CoreElectronics/CE-PiicoDev-Button/Documents/CE-PiicoDev-Button.pdf

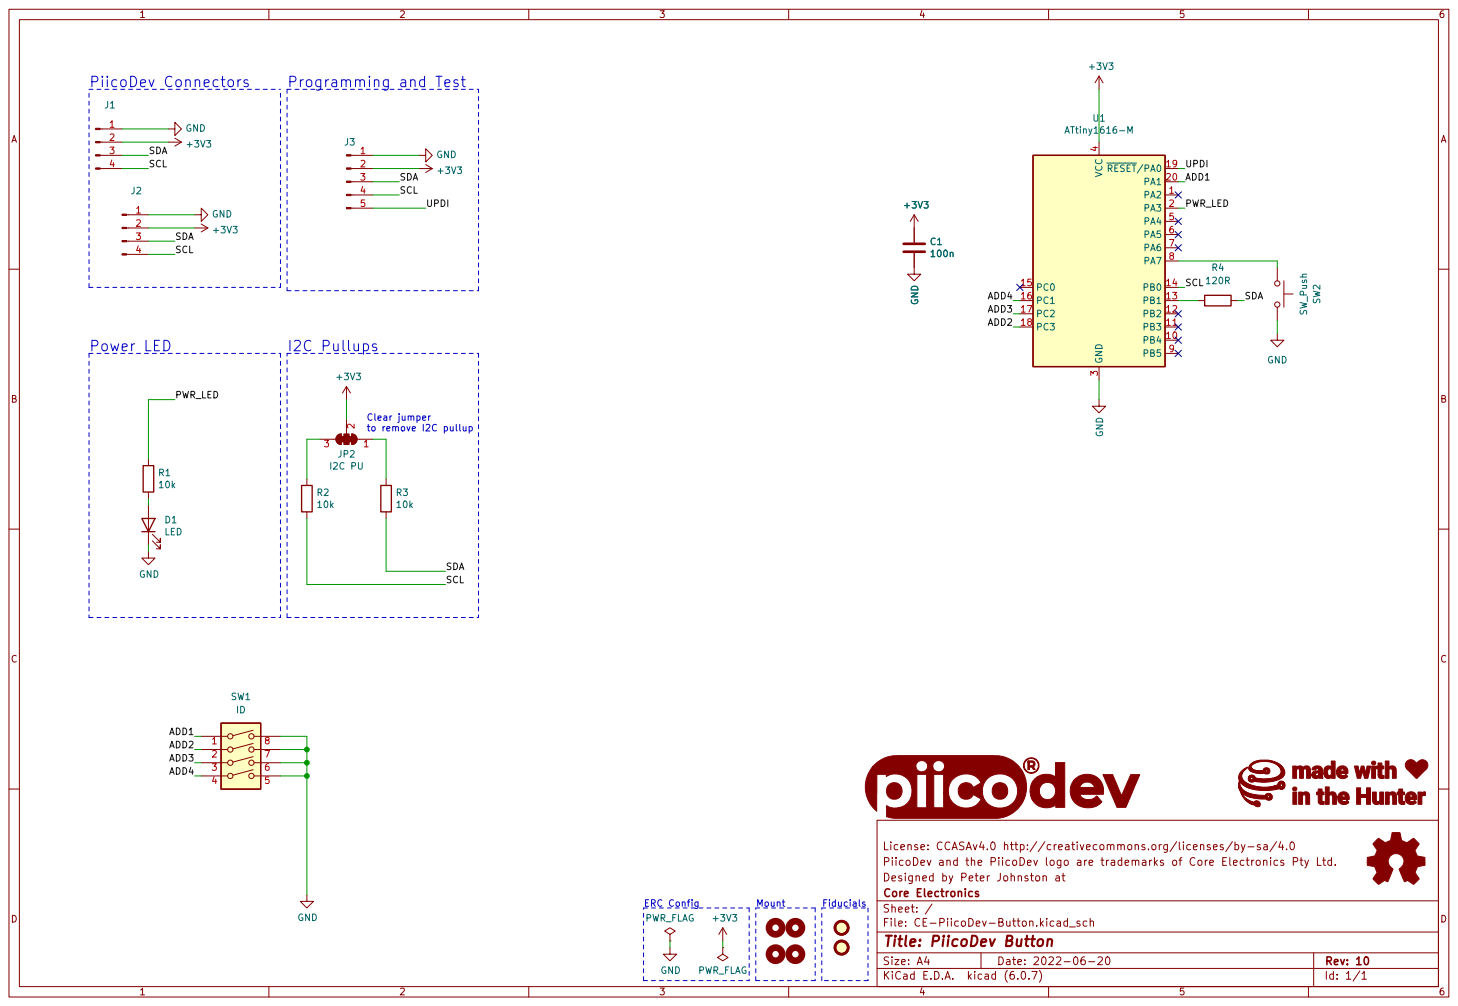
[picture p1: page 1]

License: CCASAv4.0 http://creativecommons.org/licenses/by-sa/4.0
PiicoDev and the PiicoDev logo are trademarks of Core Electronics Pty Ltd.
File: CE-PiicoDev-Button.kicad_sch Sheet: / Core Electronics Designed by Peter Johnston at

Id: 1/1 Title: PiicoDev Button
