CoreElectronics/CE-PiicoDev-Button/(commit log)

2022-04-04 Update pin connector
    [CE-PiicoDev-Button.kicad_pcb]
2022-04-13 v01 Fix Programming and Test footprint
    [CE-PiicoDev-Button.kicad_pcb, CE-PiicoDev-Button.kicad_sch]
2022-05-11 Change button pad style
    [CE-PiicoDev-Button.kicad_pcb, CE-PiicoDev-Button.kicad_sch]
2022-06-08 v03 Move LED from digital pin to PWM pin
    [CE-PiicoDev-Button.kicad_pcb, CE-PiicoDev-Button.kicad_sch]
2022-06-21 v10 Release
    [CE-PiicoDev-Button.kicad_pcb, CE-PiicoDev-Button.kicad_sch]
